danyaalh123/AXD-Parametric-Speaker-Installation/Hardware/BOM.md

### Parts List:

| Quantity | Part Description |
|---:|---|
| 1 | ATmega2560 Arduino Mega |
| 20 | TCT40-16T 40 kHz Ultrasonic Transducer |
| 1 | LM358 Operational Amplifier |
| 2 | TC4427A MOSFET Driver |
| 1 | LM2596 DC-DC Step-Down Module |
| 1 | 3.5mm Aux Cable |
| 2 | 9V Battery |
| 2 | 1kΩ Resistor |
| 2 | 100kΩ Resistor |
| 4 | 47kΩ Resistor |
| 1 | 10Ω Resistor |
| 2 | 10kΩ Potentiometer |
| 4 | 0.1μF Capacitor |
| 2 | 10μF Capacitor |
| 2 | 100μF Capacitor |
| 2 | Stripboard |
