danyaalh123/AXD-Parametric-Speaker-Installation/Hardware/Schematic.pdf

U1.132

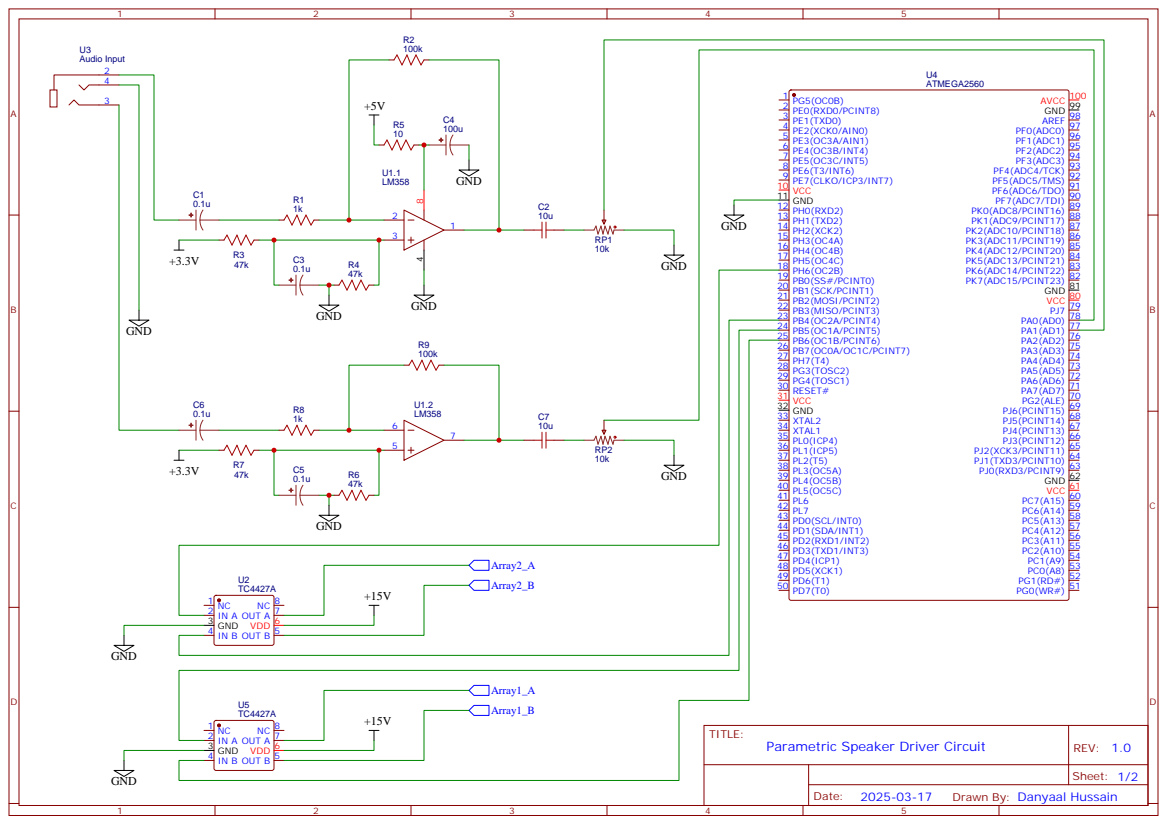
[picture p1: page 1]

Drawn By: Danyaal Hussain

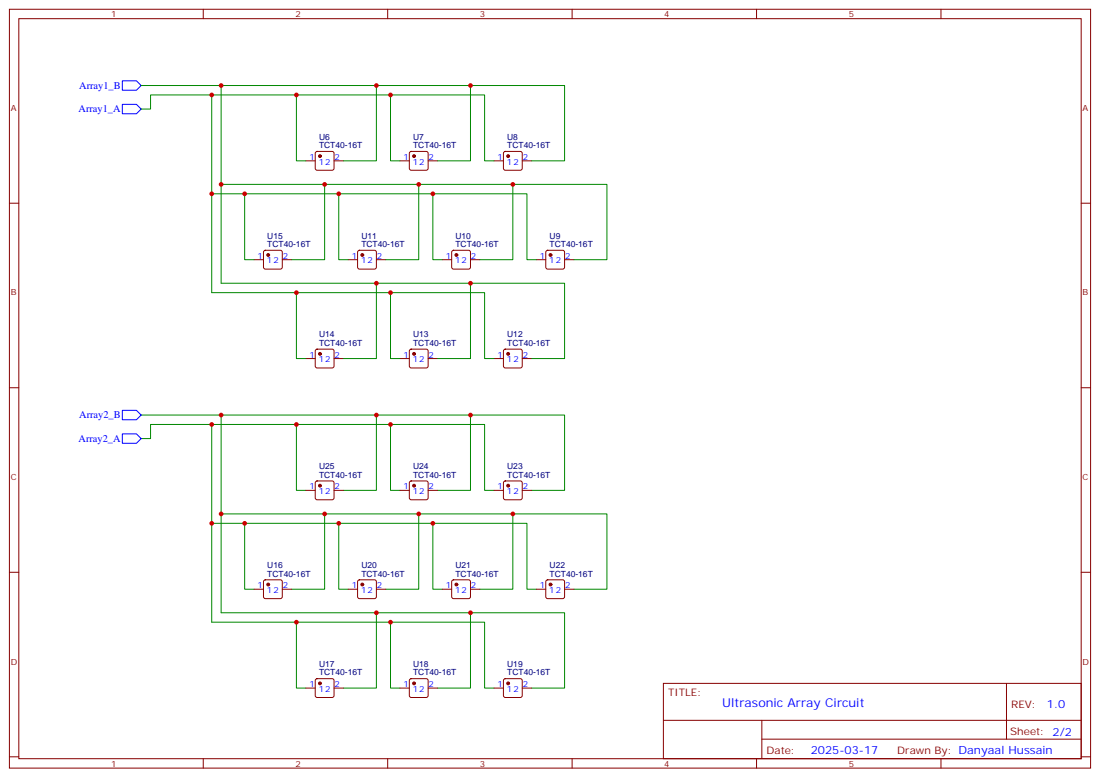
[picture p2: page 2]

Drawn By: Danyaal Hussain
