danyaalh123/AXD-Parametric-Speaker-Installation/(commit log)

2025-03-17 Rename Code/Alternate Attempts/Exponential_Moving_Average.ino to Code/Alternate Attempts/ADC Filters/Exponential_Moving_Average.ino
2025-03-17 Rename Code/Alternate Attempts/Moving_Average_Filter.ino to Code/Alternate Attempts/ADC Filters/Moving_Average_Filter.ino
2025-03-17 Rename Parts List.md to BOM.md
